Tinymaxi/ISS_Detector/Order/Screenshot 2026-09-16 at 00.33.47.jpg

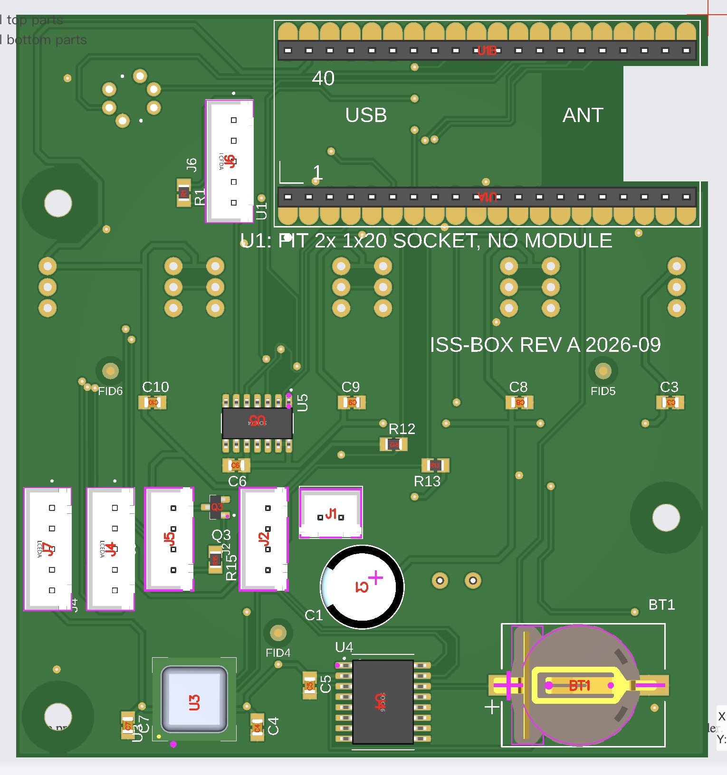
Order/Screenshot 2026-09-16 at 00.33.47.jpg
