Tinymaxi/ISS_Detector/Order/LCSC__WM2609160656_20260916214838.csv

LCSC Part Number | Manufacture Part Number | Manufacturer | Customer NO. | Package | Description | RoHS | Quantity | Unit Price($) | Ext.Price($) | Estimated lead time (business days) | Updated lead time | Date Code / Lot No.
C89924 | SB-F-02 | Senba Sensing Tech |  | - | Optoelectronics Accessories | YES | 10 | 0.1207 | 1.21
C140573 | SXH-001T-P0.6 | JST |  | - | Connector Terminal XH Tin 22~28 AWG Crimp | YES | 200 | 0.0127 | 2.54
C144404 | XHP-5 | JST |  | P=2.5mm | Connector Housing 5 Position 2.5mm Pitch Single Row XH Series PA6 -25℃~+85℃ | YES | 20 | 0.0249 | 0.50
C20417874 | HC-XH-2Y-R-05 | HCTL |  | P=2.5mm | Connector Housing 2 Position 2.5mm Pitch Single Row XH Series PA66 -25℃~+85℃ | YES | 50 | 0.0164 | 0.82
C20417882 | HC-XH-4Y-L-05 | HCTL |  | P=2.5mm | Connector Housing 4 Position 2.5mm Pitch Single Row XH Series PA66 -25℃~+85℃ | YES | 20 | 0.0331 | 0.66
