Tinymaxi/ISS_Detector/Order/ISS-BOX-order/ISS-BOX_BOM.csv

Comment | Designator | Footprint | LCSC Part #
MICS-5524 | U2 | MICS-SMD10 | C3659348
SCD41-D-R2 | U3 | XDCR_SCD41-D-R2 | C3659294
DS3231SN# | U4 | SOIC127P1032X265-16N | C722469
SN74HCT125DR | U5 | SOIC127P600X175-14N | C352957
BS612 | U6 | SENSORM-TH_BS612 | C389589
VEML7700-TR | U7 | LED-SMD_4P-L6.8-W2.4 | C504893
22850120ANG1SYA01 | U1A,U1B | PICO2W_SMT_THT | C429947
MMBT2222A | Q1,Q3 | SOT95P240X120-3N | C7420351
AO3400A | Q2 | SOT95P280X125-3N | C20917
CR1220-2 | BT1 | BAT-SMD_CR1220-2 | C70381
QMB-09B-05 | BZ1 | BUZ-TH_BD9.0-P4.00 | C161819
CC0805KRX7R9BB104 | C2,C3,C4,C5,C6,C8,C9,C10,C11,C13 | 0805 | C49678
CL21A106KAYNNNE | C7,C12 | 0805 | C15850
0805W8F4700T5E | R1 | 0805 | C17710
0805W8F1000T5E | R2 | 0805 | C17408
1RC0805F1002 | R3,R10 | 0805 | C53224213
FRC0805F1542TS | R4 | 0805 | C2930169
0805W8F1001T5E | R8,R15 | 0805 | C17513
1RC0805F8209 | R9 | 0805 | C54532367
0805W8F1003T5E | R11 | 0805 | C149504
0805W8F4701T5E | R12,R13 | 0805 | C17673
0805W8F0000T5E | R14,R17 | 0805 | C17477
0805W8F1004T5E | R16,R18 | 0805 | C17514
0805W8F1503T5E | R19 | 0805 | C17470
B5B-XH-A | J4,J6,J7 | JST_B5B-XH-A | C157991
B2B-XH-A(LF)(SN) | J1 | JST-XH-TRHU-2-PIN-FOOTPRINT | C158012
B4B-XH-A(LF)(SN) | J2,J5 | B4B-XH-A | C144395
1000uF 16V | C1 | E5-10.5 | C439782
