Tinymaxi/ISS_Detector/cad/lcsc/veml7700.obj

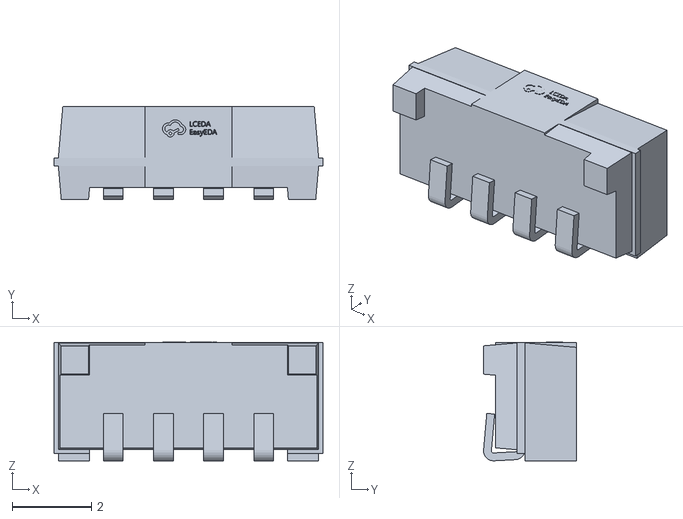
[picture p3: CAD file, 2026-09-15]
cad/lcsc/veml7700.obj
6.80 x 2.35 x 3.00
