Tinymaxi/ISS_Detector/cad/lcsc/scd41.obj

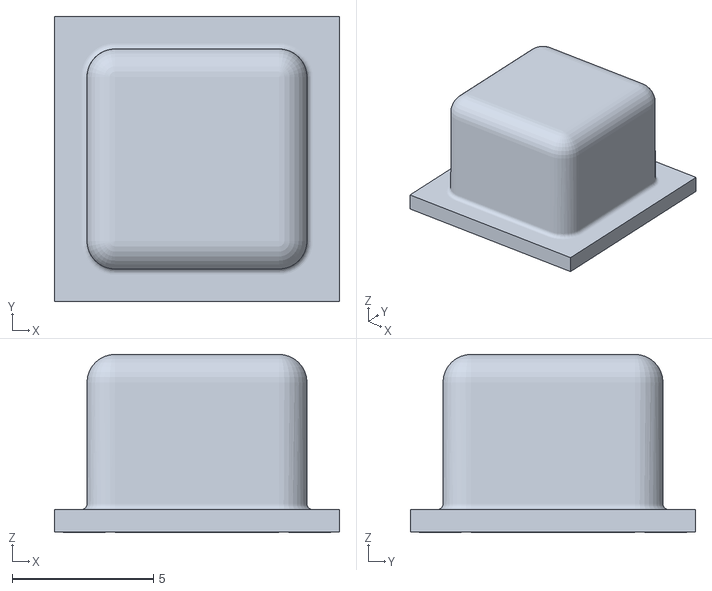
[picture p4: CAD file, 2026-09-15]
cad/lcsc/scd41.obj
10.1 x 10.1 x 6.32
