Tinymaxi/ISS_Detector/cad/lcsc/buzzer-qmb-09b-05.obj

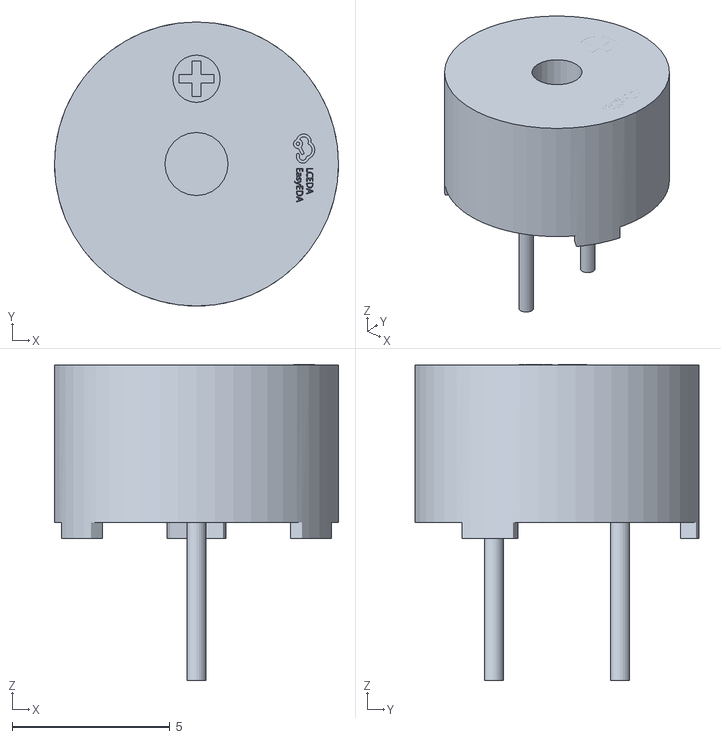
[picture p5: CAD file, 2026-09-15]
cad/lcsc/buzzer-qmb-09b-05.obj
9.00 x 9.00 x 10.0
