Tinymaxi/ISS_Detector/cad/lcsc/pir-bs612.obj

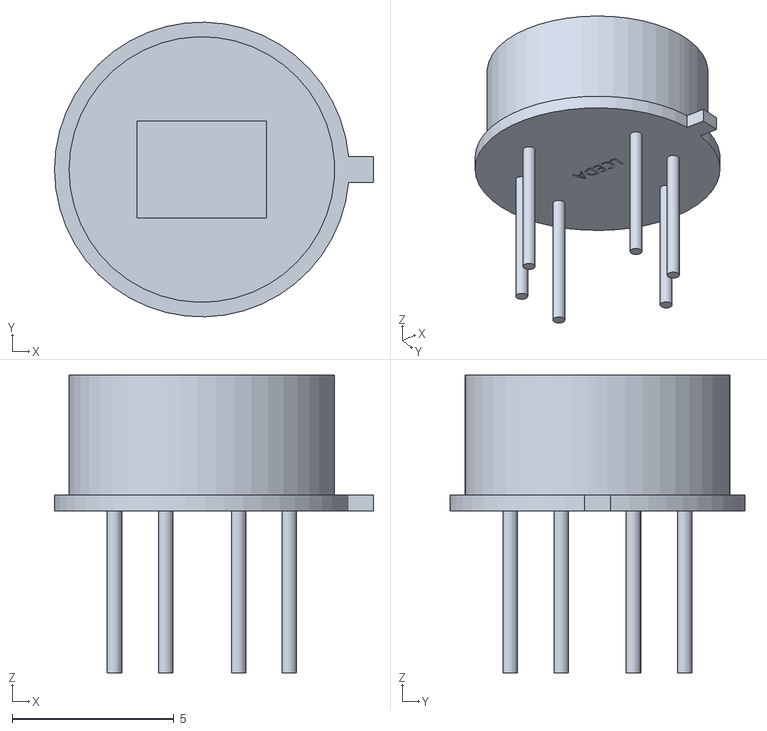
[picture p6: CAD file, 2026-09-15]
cad/lcsc/pir-bs612.obj
9.85 x 9.10 x 9.20
