Tinymaxi/ISS_Detector/cad/lcsc/cr1220-holder.obj

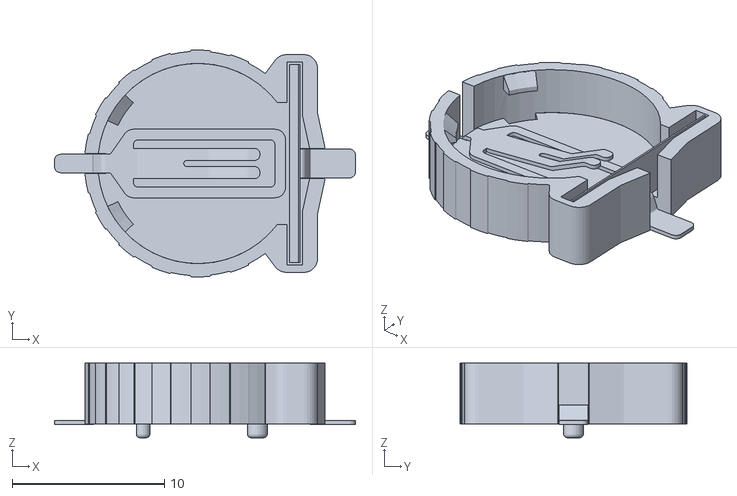
[picture p7: CAD file, 2026-09-15]
cad/lcsc/cr1220-holder.obj
19.8 x 14.9 x 4.90
