Tinymaxi/ISS_Detector/cad/lcsc/mics-5524.obj

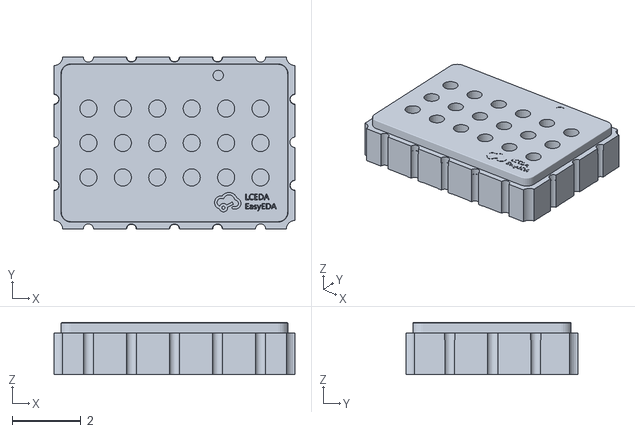
[picture p8: CAD file, 2026-09-15]
cad/lcsc/mics-5524.obj
7.00 x 5.00 x 1.52
