Tinymaxi/ISS_Detector/(list of files, cad)

Other CAD files:
cad/lcsc/buzzer-qmb-09b-05.f3d
