Tinymaxi/ISS_Detector/docs/wiring.html

# ISS-Box Wiring

Build reference for the Perma-Proto assembly — pin map, net list, modules, passives, and the order to solder them in.

Raspberry Pi Pico WH RP2040 13 of 26 GPIO used 13 nets

To print: open this page in its own browser tab, then ⌘P. It is set up for A4 portrait and prints in light colours whatever theme you are reading it in.

## Pin map

Laid out as the board physically is: pins 1–20 down the left edge, 21–40 down the right. Free pins are shown deliberately — the gaps between unrelated signals are there so the Perma-Proto Half + Quarter build has room to solder.

5 V — VBUS 3.3 V Ground Signal Free

Left edge · pins 1–20

1GP0—

2GP1—

3GNDGround rail

4GP2Ring data → 470 Ω

5GP3—

6GP4I²C SDA

7GP5I²C SCL

8GNDGround rail

9GP6—

10GP7Digit data — no resistor

11GP8—

12GP9Buzzer → 1 k → Q1 base

13GNDQ1 emitter

14GP10—

15GP11RTC SQW — 1 Hz

16GP12—

17GP13Encoder SW

18GNDEncoder GND

19GP14Encoder CLK

20GP15Encoder DT

Right edge · pins 21–40

21GP16—

22GP17—

23GNDSwitch + lamp −

24GP18—

25GP19Arcade switch

26GP20Arcade lamp +

27GP21PIR REL — motion out

28GNDPIR GND

29GP22PIR OEN — enable

30RUN—

31GP26Gas A0 ← divider · ADC0

32GP27Gas EN — low = heater on

33AGNDDivider + 100 nF ground

34GP28—

35VREF—

363V3LCD · SCD40 · Encoder +

373V3_EN—

38GNDGround rail

39VSYS5 V in · ring · digits · gas VCC

40VBUS— leave unconnected

## Modules

### NeoPixel ring 24 px

DIN | 470 Ω → pin 4
5 V | pin 40
GND | pin 38
DOUT | not connected

### NeoPixel digits 1 of 4 fitted

DIN | pin 10 direct
Series R | 330 Ω already on the module
5 V | pin 40
GND | pin 38
DOUT | → next digit

### LCD1602 RGB DFR0464

VCC | pin 36 — 3.3 V
GND | pin 38
SDA | pin 6
SCL | pin 7

### SCD40 0x62

VIN | pin 36 — 3.3 V
GND | pin 38
SDA | pin 6
SCL | pin 7
Decoupling | C4 at VIN — see passives
Peak draw | ~205 mA every 5 s
Replaces | SHT3x at 0x44 — same four wires

### DS3231 RTC 0x68

Vin | pin 36 — 3.3 V
GND | pin 38
SDA | pin 6
SCL | pin 7
SQW | pin 15 — optional
32K / RST | not connected
Battery | CR1220, fit before closing up

### Rotary encoder KY-040

+ | pin 36 — 3.3 V
GND | pin 18
CLK | pin 19
DT | pin 20
SW | pin 17

### Arcade button illuminated

Switch | pin 25 · pin 23
Lamp + | pin 26
Lamp − | pin 23

### PIR BS612

VDD | pin 36 — 3.3 V
GND | pin 28
REL | pin 27 — motion out
OEN | pin 29 — or tie to VDD
Lens | SB-F-02, 11.5 mm focal — mandatory

### Buzzer UDB-05B magnetic

+ | 5 V rail
− | Q1 collector
Q1 base | 1 kΩ → pin 12
Q1 emitter | pin 13

### USB-C breakout Adafruit 4090

VBUS | 5 V rail + Pico pin 39 · J1.1
GND | ground rail
CC1/CC2 | already resistored on the board
D+/D− | leave unconnected — power only

### Gas sensor MiCS-5524

VCC | pin 40 — 5 V
GND | pin 38
EN | pin 32
A0 | divider → pin 31

## Net list

Perfboard is built net by net, not module by module — every point on one row below is the same copper. Tick each row off as it is joined.

Net | Every point on it
GND | Pico 3, 8, 13, 18, 23, 28, 33, 38 · ring GND · digits GND · LCD GND · SCD40 GND · encoder GND · arcade switch leg · arcade lamp − · PIR GND · gas GND · Q1 emitter · divider foot · C1 − · C2 · C4 · USB-C GND
5 V | USB-C VBUS · Pico 39 · ring 5 V · digits 5 V · gas VCC · buzzer + · C1 + (bench: Pico pin 40 instead of the breakout)
3V3 | Pico 36 · LCD VCC · SCD40 VIN · DS3231 Vin · encoder + · PIR VDD · C4
SDA | Pico 6 · LCD SDA · SCD40 SDA · DS3231 SDA
SCL | Pico 7 · LCD SCL · SCD40 SCL · DS3231 SCL
SQW | Pico 15 → DS3231 SQW (internal pull-up, no resistor)
RING | Pico 4 → R1 → ring DIN (R1 at the ring end)
DIGIT | Pico 10 → digit 1 DIN, no external resistor; DOUT chains on
BUZZ | Pico 12 → R8 → Q1 base
ENC | Pico 17 → SW · 19 → CLK · 20 → DT
BTN | Pico 25 → switch · 26 → lamp +
PIR | Pico 27 → REL · 29 → OEN · 28 → GND (VDD from pin 36)
GAS | Pico 31 → divider tap + C2 · Pico 32 → EN

The 5 V rail and VSYS are the same net; 3V3 is not. The panel supply lands on both together at pin 39. 3V3 is made by the Pico itself and nothing external joins it to either.

Check the SCD40 carrier before soldering it in. The Sensirion die itself takes 2.4–5.5 V, so 3.3 V suits it — but some AliExpress carriers put a 5 V→3.3 V regulator in front, and feeding one of those 3.3 V lands it below its dropout. Look for a small three-pin regulator next to the input pins. If there is one, the board wants 5 V — and then its pull-ups put 5 V on SDA and SCL, which the RP2040 will not tolerate on a shared bus.

## Gas sensor divider

The sensor runs at 5 V and its output swings to 5 V; the ADC tolerates 3.3 V. Sized for the Raspberry Pi adapter's 5.1 V, not a round 5.0 V.

   MiCS-5524
     A0 ●
        │
      ┌─┴──┐
      │10k │  R3
      └─┬──┘
        │
        ├──────────────●  pin 31 · GP26 · ADC0
        │              │
      ┌─┴──┐         ─────
      │10k │  R4     ═════  C2 · 100 nF
      └─┬──┘           │
      ┌─┴──┐           │
      │4.7k│  R5       │
      └─┬──┘           │
      ┌─┴──┐           │
      │470 │  R6       │
      └─┬──┘           │
      ┌─┴──┐           │
      │470 │  R7       │
      └─┬──┘           │
        │              │
        └──────┬───────┘
               │
              pin 33 · AGND

Supply | At GP26 | ADC range
5.00 V | 3.050 V | 92.4 %
5.10 V nominal | 3.111 V | 94.3 % | Pi adapter
5.36 V worst case | 3.270 V | 99.1 % | Still under the rail

## Why an RTC in a WiFi box

The clock was going to come from NTP. The DS3231 changes that, and it is worth being clear about which one is in charge.

NTP cannot answer until WiFi associates — seconds of blank display on every power-up, and nothing at all if the router is down or the box is somewhere else. For a toy whose whole specification is instant-on and survives a yanked plug, that is the wrong clock. The DS3231 has the time on the bus immediately and keeps it on a CR1220 with the power off. NTP still runs — but to correct the RTC, not to be the clock.

It is a TCXO, which is the point. A plain crystal RTC drifts minutes a month as the room warms and cools. This one holds ±2 ppm — about two minutes a year — so even with the WiFi password wrong all year, the clock stays right.

Three sets of pull-ups now share the bus. LCD, SCD40 and DS3231 each bring their own 10 kΩ, so the bus sees roughly 3.3 kΩ. That is fine — about 1 mA of sink against the 3 mA these parts can take — and for a bit-banged bus the stiffer pull-up actually sharpens the rising edges.

## Digit data line

The RGBDigit datasheet, read after the digits were already working, contradicts two things we had settled.

No external resistor on the digit data line. The module already carries 330 Ω in its Di line — the datasheet says so outright: "an external resistor is not necessary". Our R2 would have put 800 Ω in series, and that is a plausible contributor to the digit fault that metered 470 Ω correctly and still would not pass data. The ring's R1 stays: that module has no resistor of its own.

The digit's logic threshold is above what the Pico can drive. VIH is 0.7 × VDD, so at VDD = 5 V a high must reach 3.5 V — and the RP2040 drives 3.3 V. On paper the margin is negative. One digit on a short breadboard lead works anyway; four soldered inside a box is where that stops being reliable. The SN74HCT125N in the parts box is the fix: power it at 5 V, GP7 into 1A, 1Y to digit 1 DIN, 1OE tied low, unused inputs to ground.

## Buzzer driver

The UDB-05B is a magnetic transducer, not a piezo: 5 V rated, 30 mA, resonant at 2300 ± 400 Hz. Both numbers matter.

                     ● 5 V rail
                     │
                  ┌──┴──┐
                  │ ⌒⌒⌒ │     UDB-05B · 30 mA · 2300 Hz
                  └──┬──┘
                     │
                     ●  collector
                    ╱
 pin 12 ──[ 1 kΩ ]──●  base        Q1 · 2N2222A (NPN)
  GP9        R8     ╲
                     ●  emitter
                     │
                     ●  pin 13 · GND

30 mA is over the RP2040's 12 mA per-pin rating. Driving the buzzer straight from GP9 runs the pin out of spec. The 2N2222A that turned out not to be needed for the arcade lamp goes here instead — and it lets the buzzer run at 5 V, which is where the datasheet's 83 dBA is measured. No code change: PWM drives a base perfectly well.

Melodies live in A6–F7 (1760–2794 Hz), straddling resonance. A magnetic buzzer off resonance is quiet and current-hungry — its impedance is mostly inductive reactance, which falls with frequency, so low notes draw more current to make less noise. The first version of these melodies sat at 260–1046 Hz, one to three octaves too low.

## Passive components

Ref | Value | Where | Why
R1 | 470 Ω | Pin 4 → ring DIN | Damps ringing. Mount close to the ring, not the Pico.
R2 | ~~470 Ω~~ none | Pin 10 → digit DIN | Do not fit. The RGBDigit already has 330 Ω in its Di line; an external one makes 800 Ω.
R3 | 10 kΩ | A0 → pin 31 | Divider, upper leg.
R4–R7 | 10 k + 4.7 k + 470 + 470 | Pin 31 → AGND | Divider lower leg in series — 15.64 kΩ total.
C1 | 1000 µF 6.3 V | 5 V ↔ GND at the pixels | Polarised. Stripe to ground. Fit with power off.
C2 | 100 nF | Pin 31 → AGND | Settles the ADC sampling.
C3+ | 100 nF | Across each pixel board | Local decoupling. Optional but cheap.
R8 | 1 kΩ | Pin 12 → Q1 base | Base current limit. Anything 470 Ω–4.7 kΩ works.
Q1 | 2N2222A | Buzzer low side | NPN. The buzzer's 30 mA is over the pin rating.
C4 | 100 nF ∥ 10 µF | SCD40 VIN → GND | Sensirion asks for both. It pulses to ~205 mA every 5 s off a 3.3 V rail the LCD also sits on — go to 100 µF if you have one.

## Power

The onboard regulator supplies 3.3 V on pin 36 for the LCD, the SCD40 and the encoder in both arrangements below. What changes is where the 5 V comes from.

### On the breadboard now

Everything through the Pico's own micro-USB connector — the Raspberry Pi USB-C adapter via a USB-C-to-micro-USB cable. VBUS (pin 40) distributes 5 V to the pixels, the gas sensor and the buzzer. One source, so nothing can back-feed anything.

### In the finished box — panel USB-C

The Adafruit 4090 breakout gives the case a proper USB-C hole instead of a micro-USB cable poking out of it. It lands on VSYS (pin 39), and the 5 V rail hangs off the same net.

  USB-C breakout · J1
     VBUS ●───────┬──────────────●  pin 39 · VSYS
                  │
                  └──────────────●  5 V rail
                                    (pixels · gas sensor · buzzer)

  Pico micro-USB ●───────────────●  pin 40 · VBUS
                                    leave unconnected

VSYS is the entry point precisely because it is not VBUS. VSYS accepts anything from 1.8 to 5.5 V, and the Pico's own VBUS reaches it through an internal Schottky — so whichever source is higher wins and neither drives current back into the other. Plugging the micro-USB in on the bench while the panel port is live is therefore safe.

Pin 40 must stay unconnected. It is the same copper as the Pico's own micro-USB 5 V. Feeding it from the panel would wire two supplies straight together the moment a USB cable goes in — which is exactly what routing to VSYS avoids.

The 1N5817 is gone. It used to sit between the panel port and VSYS, doing the job the Pico's internal Schottky already does. Feeding VSYS directly gets the same isolation for free, and a boxed unit is reflashed over SWD with a Debug Probe, which supplies no power of its own.

3.3 V for the encoder, never 5 V. Its onboard pull-ups sit on CLK and DT, so whatever feeds + is what those signal lines idle at. The RP2040 is not 5 V tolerant.

The LCD also stays on 3.3 V for the same reason — its pull-ups share the I²C bus with the Pico's pins.

## Solder order

Rails first, then one module at a time, powering up between each. A fault found after two joints is a fault you can see; found after forty, it is a hunt.

# | Fit | Then check

1 | Pico headers / socket | It seats and sits flat. Nothing else on the board yet.
2 | Ground rail, every GND point | Continuity from Pico pin 3 to every other GND point.
3 | USB-C breakout, C1 | Meter before anything is powered: 5 V rail to GND must not be a short. Then power the panel port alone — 5 V on the rail and on VSYS, which are now the same net.
4 | 3V3 from pin 36 | 3.3 V present. The Pico should now boot from the panel port on its own.
5 | I²C pair + LCD + SCD40 + DS3231 + C4 | Flash and watch the scan: 0x3E, 0x60, 0x62, 0x68.
6 | Ring, with R1 at the ring | Comet animation runs.
7 | Digits, straight to pin 10 | All four digits now — then raise DIGITS_FITTED to 4.
8 | Q1, R8, buzzer | Startup tune. Loud, if the transistor is the right way round.
9 | Encoder, arcade button + lamp | Detents count the right way; lamp breathes.
10 | Gas divider, C2, MiCS-5524 | Last because it is the fiddliest — four resistors nose to tail. Baseline settles around 0.1–0.4 V.

The one joint that has already bitten you: the 470 Ω to the digit DIN. It read 470 Ω on the meter and still would not pass data, because a probe tip pressed onto a pad makes a connection the solder does not. Tug-test that wire, and check continuity from the far end of the resistor to the digit pad itself — not to the pad it is supposed to be joined to.

## Things that read backwards

Item | What to expect
Gas EN | HIGH disables the heater. Driven low.
Encoder CLK/DT | Must be consecutive GPIO, CLK first — the PIO decoder reads them as a two-bit field.
Encoder PIO | Runs on PIO1. Its program needs instruction address 0, which WS2812 holds on PIO0.
I²C | Bit-banged in software. The hardware block never started a transfer against this LCD.
Digit pixels | 8 per digit: offsets 0–6 are segments a–g, offset 7 is the dot.
Buzzer notes | Low notes are quieter and draw more current. It is magnetic, resonant at 2300 Hz.
The transistor | It is on the buzzer, not the illuminated button — the opposite way round to the guess.
RTC SQW | Open drain. It needs a pull-up to read as anything; GP11's internal one is enough.
RTC registers | BCD, not binary. And the address pointer wraps 12h → 00h mid-read.
