Tinymaxi/ISS_Detector/src/drivers/button.hpp

// Debounced push button with an optional lamp.
//
// For the arcade button, which is the whole user interface for a five-year-old
// — one big obvious thing to hit.
//
// Wired active-low: the switch shorts the pin to GND and an internal pull-up
// holds it high otherwise, so no external resistor is needed.

#pragma once

#include <cstdint>

#include "pico/stdlib.h"

namespace drivers {

class Button {
public:
    static constexpr uint kNoLamp = 0xFFFFFFFFu;

    explicit Button(uint pin, uint lamp_pin = kNoLamp);

    void init();

    // Call every time round the main loop.
    void poll();

    bool is_pressed() const { return pressed_; }

    // True exactly once per press. Reading it consumes the event, so a slow
    // main loop cannot lose a click.
    bool take_click();

    // True once when the button has been held this long. Useful later for a
    // grown-up settings mode a child will not stumble into.
    bool take_long_press(uint32_t hold_ms = 1500);

    // The lamp runs on PWM rather than plain on/off, so it can breathe when
    // the box is idle. A softly pulsing button reads as "press me" to a small
    // child in a way a static light does not, and this is the one control they
    // are meant to find.
    void set_lamp(bool on);
    void set_lamp_brightness(uint8_t level);  // 0-255, gamma-corrected
    uint8_t lamp_brightness() const { return lamp_level_; }

    // Advances a slow sine breath. Call each loop; period_ms is one full
    // in-and-out cycle.
    void breathe_lamp(uint32_t period_ms = 2600, uint8_t min_level = 12,
                      uint8_t max_level = 200);

private:
    uint pin_;
    uint lamp_pin_;

    bool    pressed_ = false;
    bool    raw_last_ = false;
    bool    click_pending_ = false;
    bool    long_press_fired_ = false;
    uint8_t lamp_level_ = 0;
    uint    lamp_slice_ = 0;

    absolute_time_t last_change_{};
    absolute_time_t pressed_since_{};
};

}  // namespace drivers
