Tinymaxi/ISS_Detector/(commit log)

2026-08-15 Stage 1: project skeleton, blink + printf over USB
    Pico 2 W (RP2350) target, C++17 on Pico SDK 2.3.0. No SWD probe — the
    Pico 2 W debug port is a 3-pin JST-SH and no cable is on hand, so the
    console goes over USB CDC and firmware loads via BOOTSEL/picotool.
    go.sh wraps build/flash/monitor so the toolchain paths stay in one place.
2026-08-15 Add VS Code Pico extension config, align toolchain on GCC 15
    Generated by the extension's Import Pico Project wizard, with three fixes:
    - Toolchain: the wizard picked 15_2_Rel1 while CMakeLists.txt said
    14_2_Rel1, so IntelliSense modelled a different compiler than the one
    building. Everything now uses 15_2_Rel1; go.sh and .vscode agree.
    - c_cpp_properties.json claimed c++14 while we build c++17.
    - launch.json and three tasks referenced openocd.exe outside their
    Windows override blocks, which would fail on macOS. Only relevant once
    a JST-SH cable turns up, but wrong either way.
2026-08-15 Target Pico WH (RP2040), not Pico 2 W
    The board is a Pico WH 2022: RP2040 with WiFi and pre-soldered headers.
    An RP2350-family UF2 is rejected by it, which is why flashing did
    nothing — the BOOTSEL volume mounted as RPI-RP2 rather than RP2350.
    Switched PICO_BOARD to pico_w and made the boot banner print PICO_BOARD
    so the running firmware states which board it was built for.
    Verified on hardware: LED blinks, banner and heartbeat on USB CDC.
2026-08-15 Stage 2: I2C scanner with active Sensirion identification
    Scans 0x08..0x77 every 5s so modules can be hot-plugged while watching
    the console, and names the addresses this project expects.
    Rather than just listing addresses, it probes Sensirion ones to settle
    which part is fitted: SHT4x answers command 0x89 with a CRC'd 6-byte
    serial, SHT3x answers 0xF32D with a CRC'd status word. That resolves an
    open hardware question without a datasheet hunt.
    Also adds board_config.hpp as the single source of truth for pin
    assignments, with physical pin numbers for breadboard work.
    Verified on hardware with an empty bus: reports nothing found, plus the
    wiring hint.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
    [board_config.hpp, i2c_scan.cpp, i2c_scan.hpp, main.cpp]
2026-08-15 Add docs/references.md — pinouts and datasheets for the parts
    Bench reference so wiring details are in the repo rather than in chat
    scrollback. Records the gotchas found so far: the DFR0464 must run at
    3.3 V because RP2040 pins are not 5 V tolerant, MiCS-5524 EN is inverted,
    and the Pico WH SWD pins are reported swapped in Raspberry Pi's own docs.
2026-08-15 Add bus-line electrical check and write-probe scanning
    An address scan that finds nothing cannot distinguish "nothing wired" from
    "wired but not answering". i2c_check_bus_lines() settles it electrically:
    force an internal pull-down and read the pin, since a powered module's ~10k
    pull-up beats the RP2040's ~60k pull-down, while an unconnected pin does not.
    The scan now also probes each address with a one-byte write, not just a read.
    Write-only controllers such as the LCD's AiP31068 never acknowledge a read,
    so the previous scan could have missed it even when correctly wired. 0x00 is
    harmless to both devices on this bus.
    Known limitation: neither test detects swapped SDA/SCL, because the mod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
    [i2c_scan.cpp, i2c_scan.hpp, main.cpp]
2026-08-15 Stage 2: drive I2C in software; LCD found at 0x3E/0x60
    The RP2040 hardware I2C block would not talk to the DFR0464 at any speed
    from 400 kHz down to 10 kHz, always reporting a timeout with no abort
    source — meaning it never started a transfer. The same wires driven in
    software worked immediately and found the expected addresses. Root cause
    was never confirmed, and chasing it further was not worth the time for a
    bus carrying an LCD and one temperature sensor.
    So SoftI2C becomes the real driver rather than a diagnostic. It also
    gives us bus recovery: a slave interrupted mid-byte holds SDA low until
    it is clocked out, which matters for a toy whose power gets yanked
    mid-transfer and must reco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
2026-08-15 Stage 4: DFR0464 LCD driver — text and RGB backlight
    Two devices in one module: the AiP31068 character controller at 0x3E
    speaks HD44780 commands behind a control byte (0x80 command, 0x40 data),
    and a PCA9633 at 0x60 drives the backlight.
    The init sequence follows DFRobot's library including its oddities — the
    function-set command goes out four times with specific delays, because
    the controller does not reliably latch the first one. The PCA9633 powers
    up asleep, so MODE1 must be cleared before any colour appears.
    print_line() pads to 16 characters so a shorter string erases what was
    there without a full clear(), which would flicker.
    Characters go out one per transfer as DFRobot does.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
    [lcd1602_rgb.cpp, lcd1602_rgb.hpp, main.cpp]
2026-08-15 Stage 5: NeoPixel driver with gamma and a current budget
    PIO WS2812 output using the SDK's standard program, plus two things that
    happen between set() and the wire:
    Gamma correction (2.6), because WS2812 brightness is linear in PWM duty
    while the eye is not — without it "half brightness" looks nearly full.
    A frame current budget rather than a global brightness cap. 56 pixels at
    full white would draw ~3.4 A. Capping brightness would dim a single lit
    pixel for no reason, so instead the whole frame is measured after gamma
    and scaled only when it would exceed budget. A lone ISS pixel stays
    bright; a full-ring white flash gets dimmed. Default 400 mA suits
    bring-up on laptop USB; raise it on t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
    [main.cpp, neopixels.cpp, neopixels.hpp]
2026-08-15 Stage 6: seven-segment digits on their own data line
    Split the digits off the ring's chain onto GP3. Chaining would have meant
    pushing 56 pixels every frame to animate 24 of them, since the ring runs
    at 25 fps while digits change once a second. Separate lines also keep the
    breadboard wiring simpler and isolate a fault in one display from the
    other. Costs one GPIO and one PIO state machine; the WS2812 program is
    now loaded once per PIO and its offset shared between chains.
    The segment layout is taken from the Siebensegment Uhr project rather
    than guessed: eight pixels per digit, offsets 0-6 are segments a..g in
    order and offset 7 is the dot. Verified against that project's digit
    patterns.
    D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
2026-08-15 Stage 3: SHT sensor driver with runtime part detection
    SHT3x and SHT4x both live at 0x44 but speak different commands, so the
    driver identifies the part at init rather than being configured by hand:
    SHT4x answers 0x89 with a CRC'd serial, SHT3x answers 0xF32D with a CRC'd
    status word. Whichever replies validly wins, and the read path follows —
    the two also differ in conversion time and humidity formula.
    Every reply is CRC-checked and a failed check leaves the previous values
    untouched. This sensor shares a bus with the LCD, and a corrupted reading
    that looks plausible is worse than no reading.
    First cut of WETTER mode alongside: LCD shows the numbers, the ring is a
    thermometer arc fillin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
    [board_config.hpp, main.cpp, seven_segment.cpp, seven_segment.hpp, sht_sensor.cpp, sht_sensor.hpp]
2026-08-15 Stage 7: rotary encoder, and respace the pinout for hand-soldering
    The final build is hand-soldered onto an Adafruit Mint Tin PermaProto,
    where adjacent pins carrying unrelated wires invite solder bridges. Pins
    are now assigned so unrelated signals have a free pin between them, while
    pins from the same module stay adjacent — SDA/SCL, the encoder's three
    lines, button/lamp — since those arrive as one bundle and are easier to
    solder together. Only one existing wire moves: digit data GP3 -> GP7.
    Encoder decoding runs in PIO using the SDK's quadrature program, reused
    from the Rotray_Button project. Two constraints that program imposes:
    it declares .origin 0 and uses computed jumps, so it mu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
2026-08-15 Stage 8: arcade button and non-blocking buzzer
    Tone generation is lifted from ~/pico/Buzzer — choosing a PWM divider and
    wrap that land on a requested frequency is fiddly and that code is proven.
    The sequencing is replaced. That version played melodies by sleeping
    between notes, which would freeze the ring mid-animation. Here a melody
    is a state machine advanced by update(), so light and sound run together
    — the ISS alarm in particular must sound while the compass keeps
    updating. Melodies are static arrays, so playing one costs no allocation.
    Notes stop at 85% of their slot so repeated notes are heard as separate
    rather than merging into one long tone.
    Button is debounced at 8 ms, lon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
    [button.cpp, button.hpp, buzzer.cpp, buzzer.hpp, main.cpp]
2026-08-15 Arcade lamp on PWM, breathing when idle
    The lamp is now dimmable rather than on/off, and breathes slowly when
    nothing is happening. For a five-year-old a softly pulsing button reads
    as "press me" in a way a static light does not, and it is the one
    control they are meant to find.
    Gamma-corrected for the same reason the NeoPixels are: LED output is
    linear in duty cycle but the eye is not, so an ungamma'd breath spends
    most of its cycle looking fully lit rather than swelling.
    PWM runs at ~1 kHz, above any visible flicker and slow enough that a
    switching transistor stays well into saturation.
    The lamp turned out to have its own series resistor — it lit bare on
    3.3 V — so no external resis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
    [button.cpp, button.hpp, main.cpp]
2026-08-15 Drive the arcade lamp straight from GP17, no transistor
    Measurements of the lamp's current kept disagreeing with what it visibly
    does — first the meter was in AC, then on a uA range whose shunt starves
    the LED and then reports the tiny current it allowed. The observation was
    more reliable than the instrument: it lights acceptably bare on 3.3 V, so
    it is a low-current LED with its own series resistor.
    Driving it directly removes the 2N2222A and its base resistor from the
    final board, which matters when the target is a Mint Tin PermaProto.
    RP2040 pads default to 4 mA drive; GP17 is set to 12 mA so the output
    does not sag under the load.
    The transistor stays available if 5 V brightness turn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
    [button.cpp]
2026-08-15 Stage 9: MiCS-5524 gas sensor with baseline-relative scoring
    Adafruit are explicit that this sensor cannot distinguish gases and is
    only good for measuring change, so nothing here uses an absolute reading:
    the score is always relative to a slowly-tracked baseline of room air,
    which also cancels the sensor's drift over hours.
    The baseline is frozen while a measurement runs, so the puff being
    measured cannot creep into its own reference. It chases downward 8x
    faster than upward — air clearing should be followed promptly, while a
    rising reading is the signal.
    Sized the smoothing against the real update rate rather than an assumed
    one. The first attempt used an alpha picked for ~20 Hz while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
    [gas_sensor.cpp, gas_sensor.hpp, main.cpp]
2026-08-15 Fix README pinout table and document the power arrangement
    An earlier sed left the gas sensor row orphaned below a paragraph.
    Also records the divider values and why powering through the Pico's own
    USB connector removes the need for the Schottky diode and the separate
    USB-C breakout: one source cannot back-feed another.
2026-08-15 Gas divider: 10k / 15.17k for 3.01 V at full scale
    10k from A0, with 10k + 4.7k + 470 in series to ground — the closest to
    an ideal 0.6 ratio the resistors on hand can make, using 91% of the ADC
    range against 48% before.
    The remaining headroom is deliberate. USB may supply up to 5.25 V per
    spec, which puts this at 3.16 V, still under the rail. A divider tuned to
    use the last few percent of range would clip on a hot USB port, and the
    gain would be ~45 counts out of 3700.
2026-08-15 Gas divider: size for the 5.1 V Pi supply, not a round 5.0 V
    The finished box runs from the official Raspberry Pi USB-C adapter, which
    regulates to 5.1 V — deliberately high to offset cable drop — at +/-5%,
    so up to ~5.36 V. Designing around 5.0 V left range unused.
    10k from A0, 10k + 4.7k + 470 + 470 in series to ground: 15.64k, using
    every resistor on hand. 3.111 V at nominal (94% of range), 3.270 V at
    worst case, still under the rail.
    The tempting alternative — 5.64k over 10k — reaches 3.26 V at nominal,
    the most range achievable, but crosses 3.3 V at 5.16 V. A healthy adapter
    running 1% high would clip the ADC.
2026-08-17 README: correct the divider values, note where the 470s belong
    The divider description still said 14.7k from before it was resized for
    the Pi adapter's 5.1 V.
    Also records why the NeoPixel series resistors go at the pixel end rather
    than the driver end: they limit current into the first pixel's input
    protection diodes, which is a different purpose from the source-series
    termination that textbook practice would put next to the driver.
2026-08-18 Add cad/ with a fetch script for enclosure CAD models
    Verified sources for five of the parts, including exact models for the
    SCD-40 and the Mint Tin Perma-Proto the build targets. The Pico W model
    is official from Raspberry Pi; the rest come from Adafruit's CAD repo.
    The .step binaries are gitignored and the script is committed instead —
    they are third-party files, trivially re-fetchable, and would bloat the
    repo for no gain.
    Four parts have no STEP available: the MiCS-5524, the DFR0464 LCD, the
    KY-040 encoder and the buzzer. cad/README.md records where to look for
    each rather than leaving it to be rediscovered.
2026-08-18 Add SCD40/SCD41 driver, extract the shared Sensirion CRC
    The SCD4x is not a drop-in for the SHT3x: address 0x62, a different
    command set, and a different rhythm. Its photoacoustic CO2 measurement
    takes five seconds, so the driver puts the sensor into periodic mode once
    and then polls readiness rather than asking for a reading on demand.
    poll() rate-limits itself and reports true only when a fresh sample lands.
    Details that bite if got wrong, all commented in place:
    - Per-command execution delays from the datasheet. Too short is the usual
    cause of a driver that works "most of the time".
    - Only the low 11 bits of the data-ready word carry the answer.
    - The SCD4x scales by 2^16 where the SH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
    [i2c_scan.cpp, main.cpp, scd4x.cpp, scd4x.hpp, sensirion.cpp, sensirion.hpp, sht_sensor.cpp, sht_sensor.hpp]
2026-08-18 Add Perma-Proto half and quarter CAD models
    Both exist in Adafruit's repo (1609, 1608). Measured bounding boxes from
    the files rather than trusting product pages:
    quarter 50.8 x 43.2 x 1.6 mm
    half 81.3 x 50.8 x 1.6 mm
    mint tin 91.4 x 56.9 x 1.6 mm
    The quarter-size model is an outline only — 6 cylindrical surfaces against
    the half-size model's 426, so mounting holes are present but the
    perforated grid is not. Adequate for enclosure fit, no use for planning
    component placement. Recorded in cad/README.md so it is not mistaken for
    a corrupt download.
2026-08-18 Record panel cutouts for the parts with no CAD model
    The arcade button, KY-040 and buzzer are commodity parts with no
    manufacturer STEP files. For enclosure work the hole diameter matters
    more than a mesh anyway, so cad/README.md now carries those numbers:
    M28 for the button (from the BerryBase datasheet Max added), 7 mm for the
    encoder bush, 9.2 mm for the buzzer body.
    Notes two traps. KY-040 module dimensions differ between suppliers —
    15x16.5, 26x19, 30x18 and 32x19 mm are all sold as the same module — so
    the one in hand must be measured. And Adafruit's 471 model measures
    251 mm on one axis because its wire harness is modelled at full length;
    the button body is 34.4 x 29 mm.
    Co-Auth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
2026-08-18 Add USB-C breakout model, MiCS-5524 board outline, SCD40 caveat
    The 4090 USB-C breakout has a CAD model (24.8 x 14.4 x 11.7 mm), fetched.
    The MiCS-5524 has no 3D model, but Adafruit publish the PCB source, and
    the dimension layer of the EAGLE .brd gives an exact 12.70 x 19.05 mm
    outline — better than a community model would be.
    Flags a trap for the CO2 sensor: scd40.step is Adafruit's 5187 board at
    30.5 x 27.9 mm, which is NOT the generic AliExpress module actually
    fitted. Recorded so the wrong footprint does not end up in a panel
    cutout.
2026-08-18 Transpose melodies to the buzzer's resonant band
    The part is a UDB-05B magnetic transducer: 2300 +/- 400 Hz resonance,
    30 mA rated, 83 dBA at 10 cm. Datasheet added to cad/.
    Every note was written between 260 and 1046 Hz — one to three octaves
    below where this part sings. That is the worst case twice over: a
    magnetic buzzer off resonance is quiet, and its impedance is mostly
    inductive reactance which falls with frequency, so low notes also draw
    more current. Melodies now sit in A6..F7 (1760-2794 Hz), and the ISS
    alarm uses two tones straight through the peak since carrying from
    another room is its entire job.
    Six notes is a thin palette, but it is what the hardware offers.
    Separately: 3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
    [buzzer.cpp, buzzer.hpp, main.cpp]
2026-08-18 Drive the buzzer through the 2N2222A, document the panel USB-C
    The UDB-05B draws 30 mA, over the RP2040's 12 mA per-pin rating, so GP9
    now drives a base rather than the coil. The transistor is the one the
    arcade lamp turned out not to need. No code change: PWM switches a base
    as happily as an LED, and the buzzer gets its rated 5 V.
    Also brings the written schema up to date with decisions made since it
    was last touched: the 4090 USB-C breakout with the 1N5817 feeding VSYS
    (and pin 40 left unconnected, or the diode is bypassed), Perma-Proto
    half + quarter in place of the mint tin, and the SCD40 on the I2C bus.
    [buzzer.cpp, buzzer.hpp]
2026-08-21 Add the wiring sheet as a printable PDF in the repo
    The reference only existed as a hosted page, which is no use at a
    workbench with no browser session. docs/wiring.html is now the source of
    truth and lives in the repo; build-wiring.sh renders it to A4 through
    headless Chrome, which is the only converter to hand that honours the
    @page and print-colour rules.
    Fixes a stale SHT3x label on the 3V3 pin (it is the SCD40 now) and keeps
    headings with the diagram that follows them across page breaks.
2026-08-22 Record the 63.5 mm protoboard option
    SparkFun's Solder-able Breadboard (12070) is the one stock board found at
    exactly that width: 93.980 x 63.500 x 1.600 mm, confirmed from the
    dimension layer of their Eagle .brd and cross-checked against the STL
    bounding box, which agrees to 0.005 mm.
    Noted rather than adopted. It carries the same 30 columns as the
    Perma-Proto Half already in the parts list, so the extra size is margin
    rather than strips, and it has no mounting holes at all.
2026-08-22 Correct the 4090 breakout height: 4.2 mm, not 11.7
    The bounding box of Adafruit's STEP reads 11.66 mm tall, but ten points
    sit at exactly Z = -8.459 in a 0.1 mm sliver of Y with nothing between
    them and the rest of the geometry -- a flat artifact rather than a
    feature. The real board-plus-connector envelope is 4.20 mm.
    Worth 7.5 mm of clearance when planning where the panel port sits, and
    the same trap the arcade button model set with its 228 mm wire harness.
2026-08-23 Collect every datasheet into datasheets/
    The two PDFs we had were sitting in cad/ next to the 3D models. They now
    live in datasheets/ with the other eleven, an index explaining where each
    came from, and a fetch.sh for the ones with a public URL. These PDFs are
    committed rather than gitignored: datasheet links rot, and the point of
    the folder is that the numbers outlive the URLs.
    Three come from mirrors because onsemi and NXP answer 403/404 to anything
    that is not a browser; the PCA9633 is consequently Rev. 05 rather than the
    current 6.0, which the index says plainly.
    The RGBDigit datasheet contradicts two build decisions, so the wiring
    sheet changes with it:
    - R2 must NOT be fitted. The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
2026-08-23 Add the DS3231 RTC: pins, model, datasheet, docs
    Adafruit 3013 joins the I2C bus at 0x68 -- no collision with the LCD's
    0x3E/0x60, the SCD40's 0x62, or the PCA9633 all-call echo at 0x70. So it
    costs no new bus pins, only SQW.
    SQW goes on GP11 (physical 15). That keeps a free pin either side: GP10
    after the buzzer, GP12 before the encoder bundle. Open-drain, pulled up
    internally, no resistor. Optional in principle -- the time can just be
    read over I2C -- but wired now because adding a wire to a sealed box is
    the hard way to do it.
    This demotes NTP. The clock was going to come from the network, which
    cannot answer until WiFi associates: seconds of blank display on every
    power-up and nothing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
    [board_config.hpp, i2c_scan.cpp]
2026-08-23 Add the 40-pin header table and the naming crib
    RP2040 is the chip, Pico the board, Pico WH the one on the bench. Worth
    writing down: the RP2350/Pico 2 naming makes it easy to reach for the
    wrong datasheet.
    The pin table is from Figure 2 of the Pico W datasheet, for transcribing
    into a schematic symbol. Notes that AGND on pin 33 wants its own pin
    rather than merging into common ground -- the gas divider returns there.
2026-08-25 Scout the move from breakouts to bare SMD parts
    What it would take to have the SCD4x, MiCS-5524 and DS3231 placed by an
    assembly house instead of arriving as breakout boards. Records the MPNs,
    the support circuitry each breakout was providing for free, SMD
    equivalents for the discretes, where Fusion libraries come from, and
    quotes from AISLER and PCBWay.
    Marked as scouting throughout — nothing in the schematic has changed and
    the hand-soldered Perma-Proto build is still the build.
    Six open questions carried at the end, the blocking one being the real
    R_LOAD value on Adafruit's MiCS-5524 breakout: the existing gas divider
    maths is calibrated against it and guessing would move the ADC rang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
2026-09-15 Document the JLCPCB route and the parts it settled
    Adds cost-comparison.md (with the resolved AISLER quote that pushed the
    decision) and pcb-tht-breakouts.md (the abandoned bare-board detour, kept
    for its account of what the breakouts were providing).
    Datasheets for the parts chosen since: the CR1220 holder, the Pico socket,
    the BS612 PIR, its SB-F-02 lens, the CST-951AP buzzer, and Sensirion's
    SCD4x design-in guide.
    cad/ gains the LCSC-sourced meshes and the scripts that turn them into
    STEP, plus the lens primitive.
    [buzzer-qmb-09b-05.f3d, buzzer-qmb-09b-05.obj, cr1220-holder.obj, mics-5524.obj, pir-bs612.obj, scd41.obj, veml7700.obj]
2026-09-15 Add the EDA work: libraries, BOMs and a CPL generator
    Hand-checked .lbr files for the parts Fusion does not carry, each verified
    against its datasheet rather than trusted from the download — the CR1220
    holder's polarity came from the manufacturer's own PCB layout diagram, and
    the BS612's pin numbering from the raw EasyEDA records.
    make-jlc-cpl.py turns Fusion's Pick-and-Place export into a JLCPCB CPL.
    It exists because two things were previously done by hand in a spreadsheet
    and so could never be regenerated: splitting U1 into the two socket strips
    that actually get soldered, and the per-package rotation corrections that
    JLCPCB's assembly preview revealed. Both are now rules in one file,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
    [BOM.csv, BOM_1.csv, bom-smd-only.csv, bom-tht.csv, bom.csv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]
2026-09-15 Record what was sent to JLCPCB for order W2026091606514059
    The gerbers as uploaded, the BOM and CPL as uploaded, the CAM job that
    produced them, and screenshots of the placement preview that was approved.
    Five boards, all five assembled. Standard PCBA both sides, ENIG, nitrogen
    reflow, 1x1 panel with 5 mm rails. C429947 was out of stock for the Pico
    sockets and was substituted with C53202183 — same 8.5 mm, 3 A, gold.
    The screenshots matter more than they look: after the CPL was uploaded,
    some parts were rotated by hand in JLCPCB's placement editor and the list
    of which ones was not kept. The pictures are the only record of what was
    actually approved, so a re-order must check the preview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
    [ISS-BOX_BOM.csv, PnP_PCB_back.csv, PnP_PCB_front.csv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]
2026-09-15 Move the firmware onto the fabricated board's pinout
    Arcade button and lamp go to GP19/GP20, the PIR arrives on GP21/GP22, and
    5 V now enters at VSYS rather than VBUS.
    The gas sensor's EN polarity inverts. On the Adafruit breakout, EN high
    disabled the heater because the breakout carried its own switching
    transistor. On this board EN drives Q2's gate directly, so high enables.
    R11 holds the heater off between power-on and this code running.
    NOTE: this makes the firmware incompatible with the running Perma-Proto
    build, which still uses the breakout and the old pin assignments. Do not
    flash the prototype from this branch.
    [board_config.hpp, gas_sensor.cpp, gas_sensor.hpp]
2026-09-16 Drive all four digits on the fabricated board
    The Perma-Proto prototype only ever had one RGBDigit wired, so the chain
    was sized to one. The board carries all four.
2026-09-16 Record LCSC order WM2609160656
    The loose parts that JLCPCB will not ship with a PCBA order: PIR lenses,
    JST XH crimps and housings. Ships on its own, not combined.
    [LCSC__WM2609160656_20260916214838.csv]
2026-10-10 Read the PIR, and write down what the first board taught us
    Bring-up found two sensors wrong, both from footprints we drew: the light
    sensor is the side-view variant and went on reversed, which clamped the whole
    I2C bus; the PIR's pad ring is mirrored, so it cannot go in the right way up.
    docs/rev-a-rework.md has the evidence and the fix for each.
    The PIR pins and read are real firmware, ready for a rewired sensor. go.sh now
    picks the newest serial port, since the board re-enumerates after a reset.
    [board_config.hpp, main.cpp]
2026-10-10 Note that flipping the PIR cancels the mirrored footprint
    Fitting it from the underside mirrors its leads, so every pin lands on the
    right pad with no wires. The dome then faces the other way, which the case has
    to allow. No six-pin PIR exists with the mirrored pinout, so those are the two
    options.
